Daviedz/ESP-Audio-Player/README.md

# ESP Audio Player

A retro, Winamp-inspired MP3 / FLAC / WAV player and internet radio built on the **Freenove FNK0104B** (ESP32-S3, 2.8" touch display), with a 3D-printable rugged "steel" enclosure.

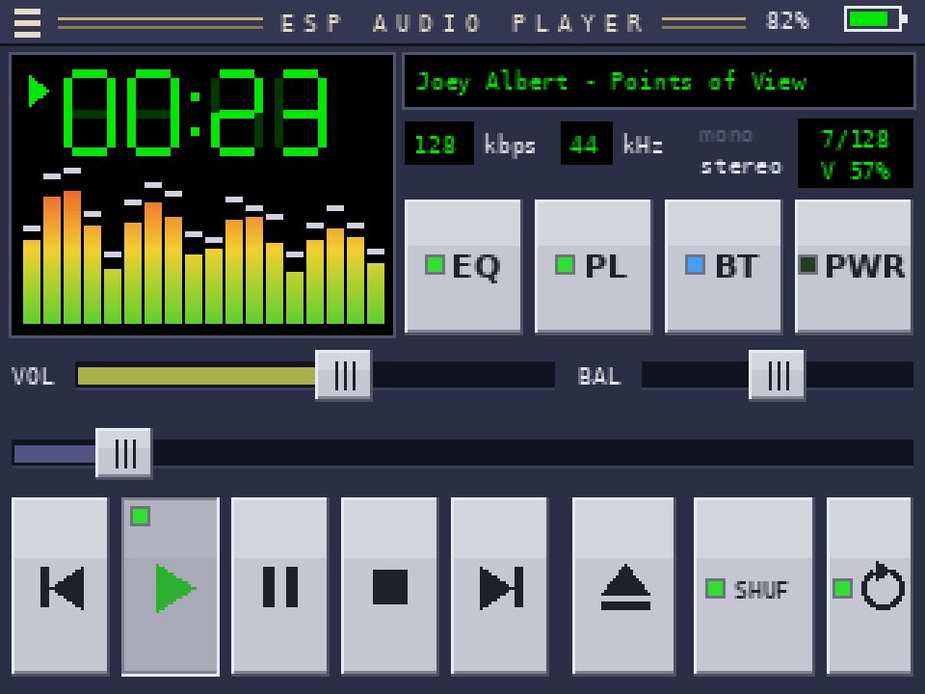
[picture p1: docs/images/retroplay_ui_preview.png]
Main screen


## Features
- RetroPlay-style touch UI: 7-segment time display, spectrum analyzer, scrolling title, silver buttons with indicator lights
- Plays MP3 / FLAC / WAV from microSD (folders, playlists, sort, shuffle, repeat all / one)
- Internet radio over Wi-Fi
- Equalizer with presets, volume + balance, 30-step smooth volume curve
- Remembers settings and the last song + position after power-off
- Battery indicator, low-battery shutdown, power off / wake with a button
- External buttons: POWER, VOL+, VOL-
- Optional Bluetooth transmitter output (Speaker / BT / Both)
- Animated boot screen

| Boot animation | Other screens |
|---|---|
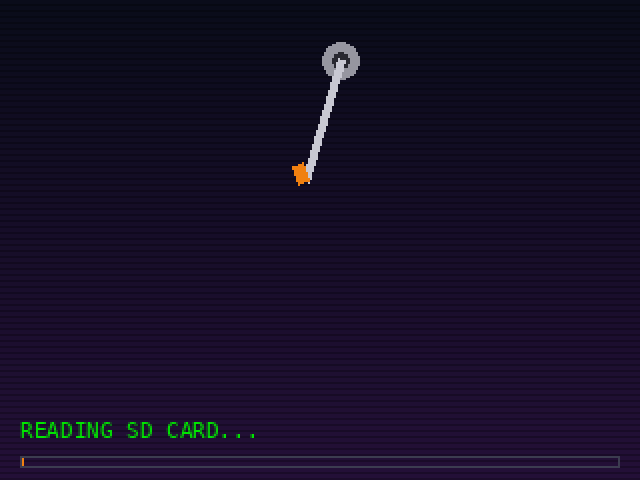
[picture p2: docs/images/boot_animation_preview.gif]
Boot
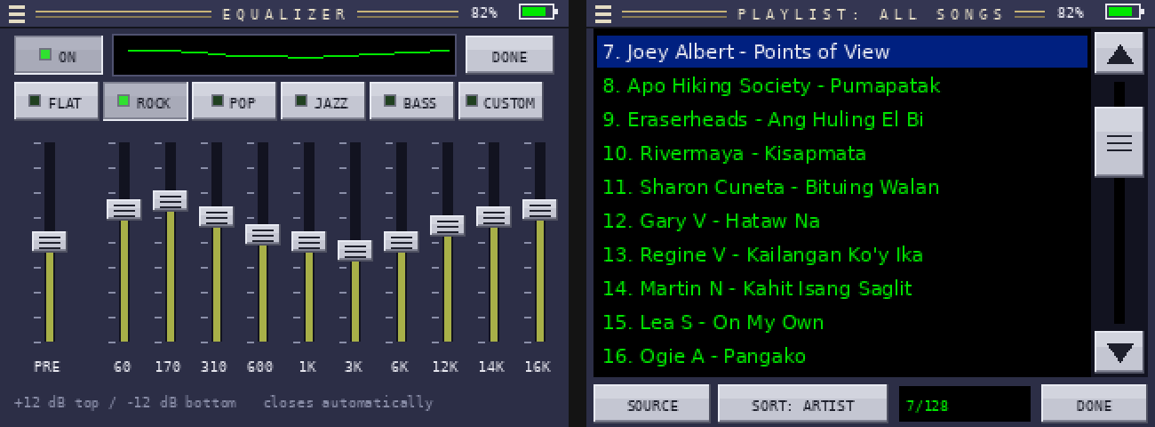
[picture p3: docs/images/retroplay_screens_preview.png]
Screens
|  |  |

## Hardware
| Part | Notes |
|---|---|
| Freenove FNK0104B (ESP32-S3R8, 16 MB flash, 2.8" ILI9341 + FT6336 touch) | ES8311 codec + SC8002B amp on board |
| 2 x 40 mm speaker (SQ-157E, 4 ohm) | mono output |
| 3.7 V 2000 mAh LiPo | |
| 3 x push buttons | POWER = IO21, VOL- = IO2, VOL+ = IO14 (other side to GND) |
| Panel-mount USB-C and microSD extension cables | |
| Optional Bluetooth transmitter (e.g. KCX_BT_EMITTER) | power switched by IO3, audio from ES8311 OUTP |

## Build the firmware
1. Arduino IDE with **esp32 by Espressif** board package (3.x).
2. Libraries: **ESP32-audioI2S** (schreibfaul1), **arduino-audio-driver** (pschatzmann), **LovyanGFX**.
3. Tools settings: Board **ESP32S3 Dev Module**, PSRAM **OPI PSRAM**, Flash **16MB**, Partition **Huge APP (3MB No OTA)**.
4. Open `firmware/WinampPlayer/WinampPlayer.ino` and upload.

### USB drive mode (add songs without removing the SD card)
Tools settings for this feature: **USB Mode = USB-OTG (TinyUSB)** and **USB CDC On Boot = Disabled** (with CDC on boot the drive cannot start).
On the player open **PWR > USB DRIVE**: it reboots, the SD card shows up as a drive on the PC (use the board's native USB-C port), copy your songs, **eject the drive on the PC**, then touch **EXIT** (or hold BOOT). The player reboots and rescans the card.
Notes: with these settings the board shows no USB serial port in normal mode, so to upload new firmware hold **BOOT** while plugging in the USB cable. With the default USB Mode the USB DRIVE button just shows a message. If drive mode ever stops unexpectedly the next boot shows the last step and reset code on screen.

Options are at the top of the sketch (`AUTOPLAY_ON_BOOT`, `LCD_ROTATION`, `VOL_MAX_DB`, button pins, Bluetooth pins, `BOOT_ANIM`).

## SD card
- Copy music in any folders (MP3 / FLAC / WAV).
- Playlists: `/playlists/*.m3u` (created from the player too).
- Wi-Fi for radio: create `/wifi.txt` with one `NAME,PASSWORD` per line. Keep this file off GitHub.
- Live radio shows the local time (HH:MM, fetched over NTP) instead of a timer. Set your time zone with `TZ_DEFAULT` in the sketch or a one-line `/timezone.txt` (POSIX TZ string, e.g. `CET-1CEST,M3.5.0,M10.5.0/3`). Default is UTC+8. Shows `--:--` until the time is synced.
- Radio stations: `/radio.txt`, one station per line:
  ```
  # Name, stream URL
  Radio 1, http://136.243.44.41:8010/stream
  My Station, http://example.com:8000/stream
  ```
  Up to 60 stations. If the file is missing the player creates a sample one on the first boot.

## Enclosure
OpenSCAD source and print-ready STLs in [`enclosure/`](enclosure/) — all parts print **without supports** (Bambu Lab P1S, PLA / PETG settings in the spreadsheet). Colourways: orange/white, black/orange, purple/orange.

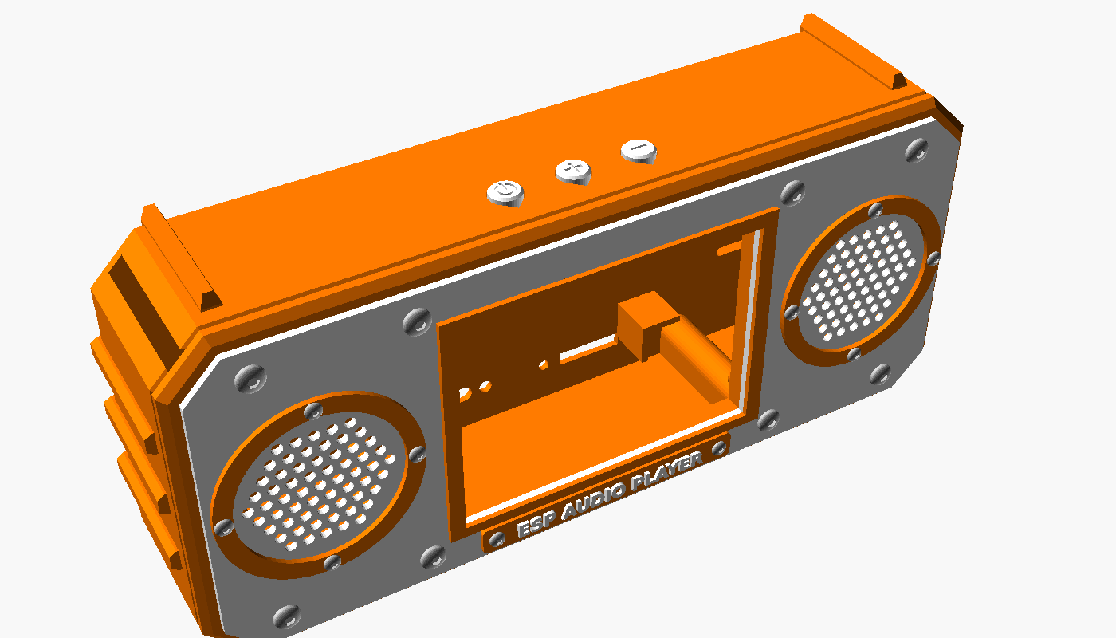
[picture p4: enclosure/images/front_3q.png]
Enclosure


**Print-ready for the Bambu Lab P1S (PLA):** sliced `.gcode.3mf` files in [`enclosure/print_P1S/`](enclosure/print_P1S/) - copy to the SD card and print. See [PRINT_GUIDE.md](enclosure/print_P1S/PRINT_GUIDE.md).

## License
MIT — see [LICENSE](LICENSE).
