Daviedz/ESP-Audio-Player/enclosure/images/back_3q.png

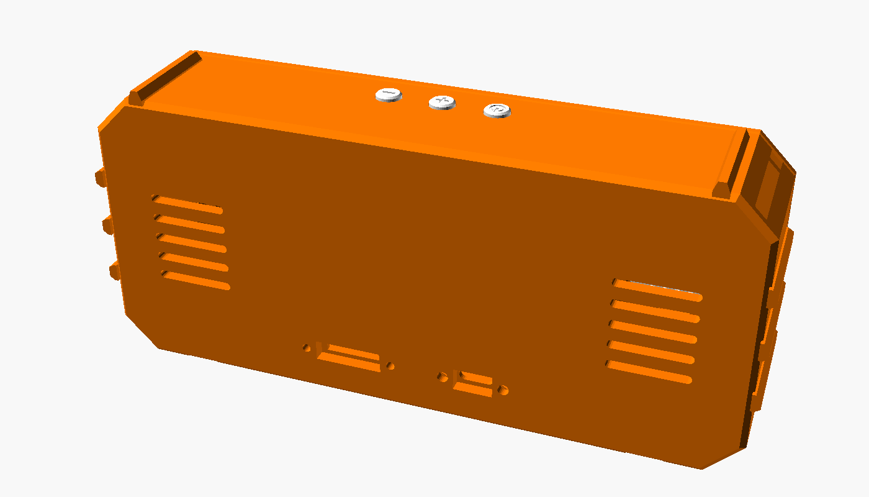
enclosure/images/back_3q.png
