Daviedz/ESP-Audio-Player/enclosure/images/cw_black_orange_3q.png

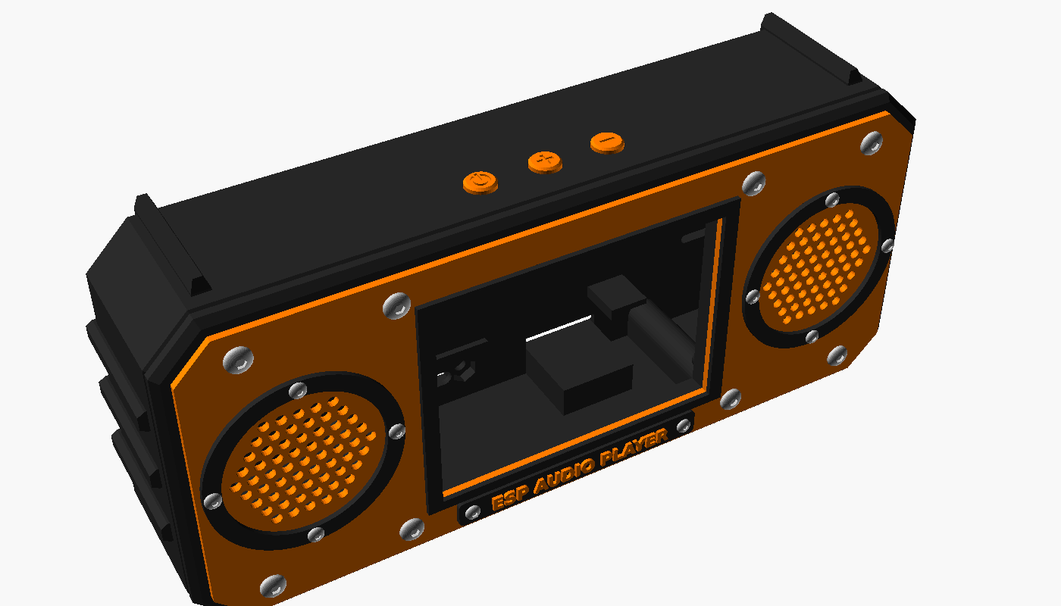
enclosure/images/cw_black_orange_3q.png
