Daviedz/ESP-Audio-Player/enclosure/images/cw_purple_orange_3q.png

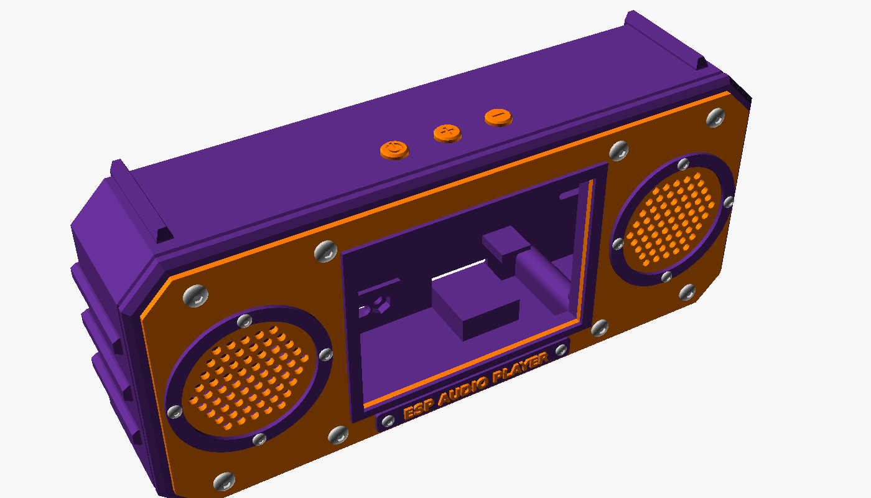
enclosure/images/cw_purple_orange_3q.png
