Daviedz/ESP-Audio-Player/enclosure/images/front_flat.png

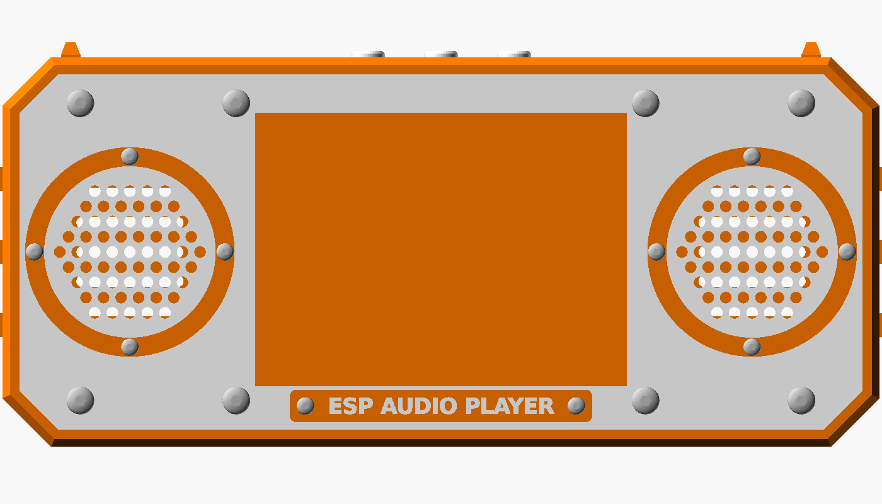
enclosure/images/front_flat.png
