Daviedz/ESP-Audio-Player/enclosure/images/ports_inside.png

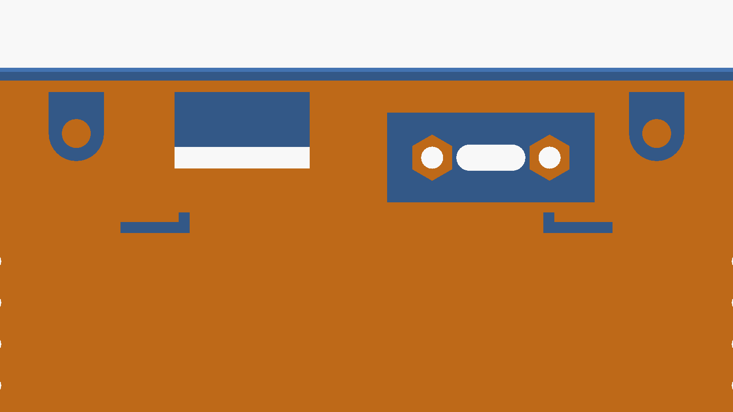
enclosure/images/ports_inside.png
