Daviedz/ESP-Audio-Player/enclosure/images/speaker_mount.png

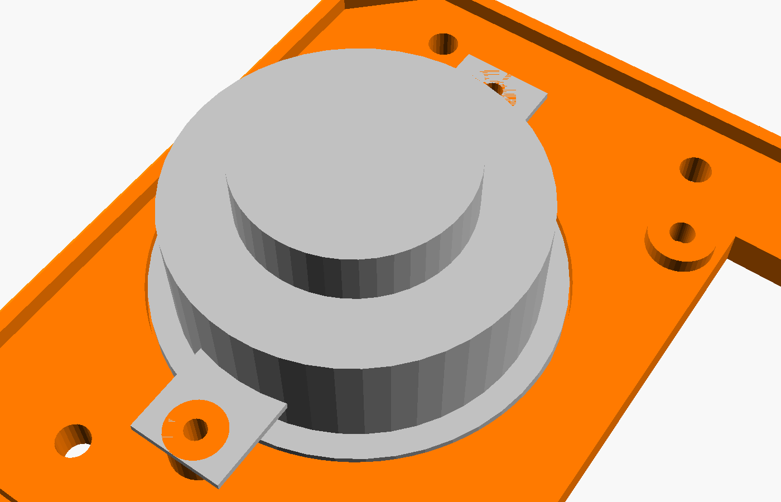
enclosure/images/speaker_mount.png
