Daviedz/ESP-Audio-Player/enclosure/P1S_PLA_PETG_print_settings.xlsx

Sheet: Filament Profiles
Bambu Lab P1S - filament profiles
Printer: Bambu Lab P1S, 0.4 mm nozzle, PLA vs PETG
Setting | PLA | PETG | Notes
Filament preset | Bambu PLA Basic (or any PLA) | Bambu PETG Basic (or any PETG) | Start from the Bambu Studio generic preset for the P1S, 0.4 mm nozzle
Nozzle temperature (C) | 220 | 255 | PLA 215-225, PETG 250-260. First layer same or +5 C
Bed temperature (C) | 55 | 70 | Textured PEI. Smooth PEI: PLA 45-55, PETG 70-75 with glue stick
Build plate | Textured PEI (or Cool Plate) | Textured PEI. Smooth PEI only with glue stick | PETG bonds too hard to bare smooth PEI - use glue stick as a release layer
Part cooling fan (%) | 100 | 30-50 (min 20 / max 50) | Less fan = better layer bonding on PETG
Aux fan (%) | 100 | 30-50 | Keep low for PETG to reduce warping
Chamber / door | Door OPEN or top lid off | Door CLOSED, lid on | PLA softens above ~45 C inside the chamber and can clog (heat creep)
Max volumetric speed (mm3/s) | 18 | 10 | Use 14 for PLA if you want quieter, cleaner walls
Retraction length (mm) | 0.8 | 0.8 | PETG: also enable wipe, keep z-hop 0.4 mm
Outer wall speed (mm/s) | 120 | 80 | Visible orange / white faces - slower looks better
Inner wall speed (mm/s) | 200 | 150
Infill speed (mm/s) | 250 | 150
Bridge speed (mm/s) | 40 | 35 | Used for the port-recess bridges in the shell
Seam position | Back / Aligned | Back / Aligned | Keeps the seam off the visible front
Drying before print | 55 C, 6-8 h | 65 C, 6-8 h | Dry PETG especially if it strings or hisses
Glass transition / heat resistance | ~55-60 C | ~75-80 C | PETG is the safer choice for the body: LiPo, amp and sunlit use
Strength / feel | Stiff, sharp details, brittle | Tougher, slightly flexible, glossy | PLA gives crisper letters and bolt heads
Recommended use in this project | Front plate, white face plate, orange trim, letters, bolt heads, keys | Shell, key bracket (and front plate if you want a heat-resistant body) | Mixing is fine: PLA for the show face, PETG for the shell
Values are typical starting points for Bambu filaments - check the spool label and tune with a small test print.

Sheet: Process Settings
Process settings (both materials)
Slicer: Bambu Studio
Setting | PLA | PETG | Notes
Layer height (mm) | 0.20 (0.12 for letters, heads, keys) | 0.20 (0.16 for keys) | Process preset: 0.20 mm Standard @BBL X1C/P1S
Line width (mm) | 0.42 | 0.42 | Outer wall 0.42
Wall loops | 4 | 4 | Shell and front plate carry the screws and inserts
Top / bottom shell layers | 5 / 4 | 5 / 4 | Overlay, trim: 100% solid (thin parts)
Infill density | 15-20 % | 20-25 % | Gyroid for both
Infill pattern | Gyroid | Gyroid
Support | OFF | OFF | Model is designed support-free
Brim | None (Outer brim 3 mm for the shell if corners lift) | Outer brim 3 mm on shell and front plate | Brim helps PETG on textured PEI edges
Elephant foot compensation (mm) | 0.1 | 0.1 | Matters for the front plate / shell bed edge
Ironing | OFF | OFF
Arc fitting | ON | ON
Z hop (mm) | 0.4 | 0.4 | Avoid drag marks on the front face
Slow down for overhang | ON | ON | Bridges in shell: flow ratio 0.95
Detect thin walls | ON | ON | Letter strokes are ~0.7 mm
Fuzzy skin / adaptive layers | OFF | OFF

Sheet: Per-Part Settings
Per-part settings
All parts print without supports
STL | Part | Colour | Qty | Orientation | Material | Layer (mm) | Walls / infill | Support | Notes
steel_front.stl | Front plate | Orange | 1 | Front face DOWN (as exported) | PLA or PETG | 0.20 | 4 walls, 20 % | None | Needs M3 holes + heat-set insert clean. Large flat part: PETG add brim
steel_overlay.stl | White face plate (1.6 mm) | White | 1 | Flat on bed (face down) | PLA | 0.20 | 100 % solid (thin) | None | Glue to the front plate; perforations print upright
steel_trim.stl | Bezel, speaker rings, nameplate base (1.2 mm) | Orange | 1 | Flat on bed | PLA | 0.12-0.20 | 100 % solid | None | Glue on top of the white plate
steel_letters.stl | Letters ESP AUDIO PLAYER (0.8 mm) | White | 1 | Flat on bed | PLA | 0.12 | 100 % solid | None | Thin strokes - use 0.12 mm, slow 40 mm/s first layers
steel_heads_small.stl | Small round bolt heads 3.6 mm (speaker rings + nameplate) | Silver / white | 10 | Dome UP | PLA | 0.12 | 100 % solid | None | Print the 10 together, glue on
steel_heads_big.stl | Big round bolt heads 5.7 mm (front corners, optional vs real screws) | Silver / white | 8 | Dome UP | PLA | 0.12 | 100 % solid | None | Print the 10 together, glue on
steel_shell.stl | Rear shell | Orange | 1 | Back face DOWN, open side up (as exported) | PETG (preferred) or PLA | 0.20 | 4 walls, 20-25 % | None | Bridges <= 6.4 mm at port recesses and switch pockets are fine; brim 3 mm
steel_bracket.stl | Key switch bracket | Any | 1 | As exported | PETG or PLA | 0.16 | 100 % | None | Switch pockets bridge ~6 mm
steel_keys.stl | 3 key caps | White | 3 | Flange DOWN | PLA | 0.12-0.16 | 100 % | None | Check 7.0 mm cap moves freely in 7.4 mm hole

Sheet: Notes
Notes
- Print order: shell first (longest print, also checks the ports), then front plate, then the thin parts.
- Test fit: print the front plate or a small port test before the full set.
- Two-colour nameplate: letters can be glued on, or print trim + letters together and add a colour change at 1.2 mm.
- Hardware: 8 x M3x12 ISO 7380 button-head screws, 8 x M3 heat-set inserts, 2 x M3x6 + 2 x M3 nuts (USB-C), 2 x M2x8 bracket screws, 3 tact switches 6x6x5.
- PETG note: do not print PETG directly on smooth PEI without glue stick - it can tear the plate coating.
- PLA note: keep the P1S door open / lid off for long prints to avoid heat creep.
- Source: typical Bambu Lab PLA Basic / PETG Basic profiles and common P1S practice; values are starting points, not guarantees.
