Daviedz/ESP-Audio-Player/enclosure/print_P1S/1_shell_PLA_orange.gcode.3mf

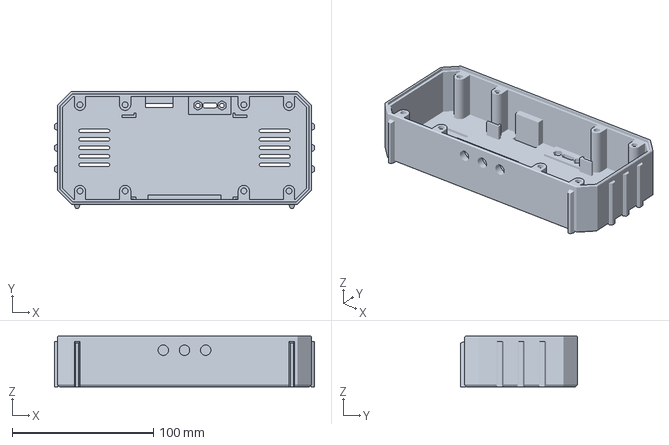
[picture p11: CAD file, 2026-11-07]
enclosure/print_P1S/1_shell_PLA_orange.gcode.3mf
184.0 x 83.0 x 36.0 mm
