Daviedz/ESP-Audio-Player/enclosure/print_P1S/6_small_parts_PLA_white.gcode.3mf

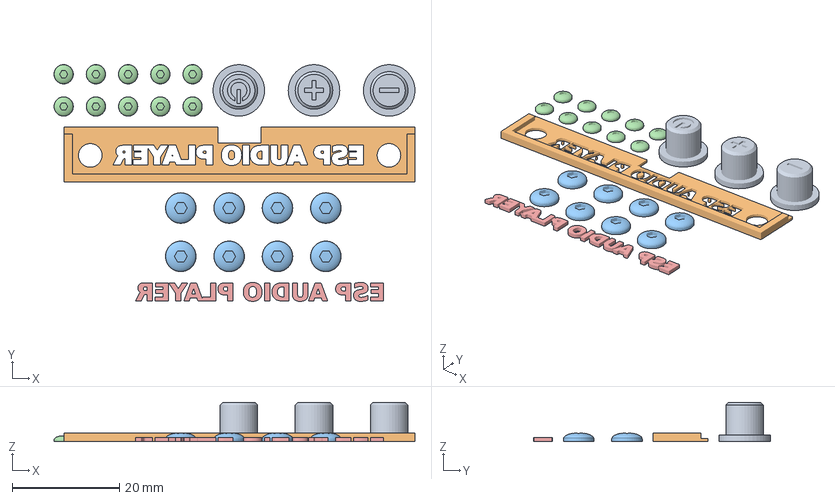
[picture p12: CAD file, 2026-11-07]
enclosure/print_P1S/6_small_parts_PLA_white.gcode.3mf
67.2 x 44.1 x 7.30 mm
D:/Claude Project/ESP-Audio-Player-main/enclosure/stl/steel_keys.stl
D:/Claude Project/ESP-Audio-Player-main/enclosure/stl/steel_letter_jig.stl
D:/Claude Project/ESP-Audio-Player-main/enclosure/stl/steel_heads_big.stl
D:/Claude Project/ESP-Audio-Player-main/enclosure/stl/steel_heads_small.stl
D:/Claude Project/ESP-Audio-Player-main/enclosure/stl/steel_letters.stl
