Daviedz/ESP-Audio-Player/enclosure/stl/steel_bracket.stl

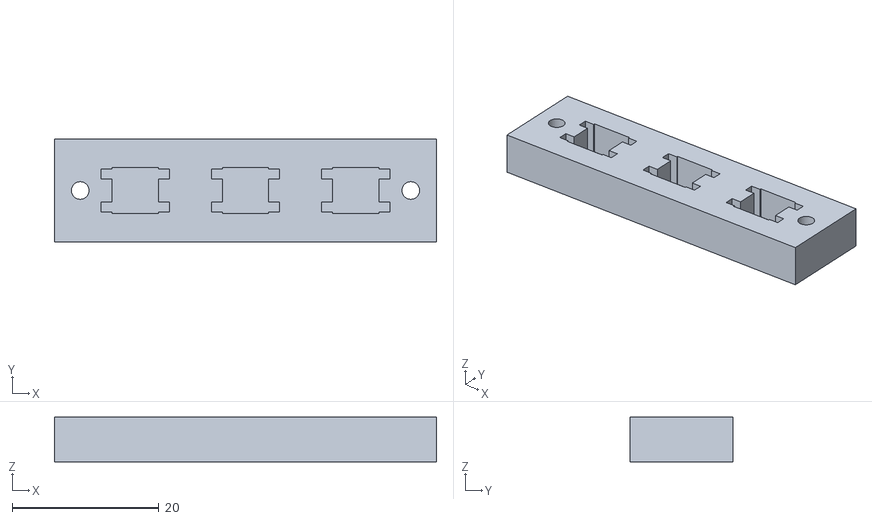
[picture p13: CAD file, 2026-11-05]
enclosure/stl/steel_bracket.stl
52.0 x 14.0 x 6.10
