Daviedz/ESP-Audio-Player/enclosure/print_P1S/4_white_face_plate_PLA_white.gcode.3mf

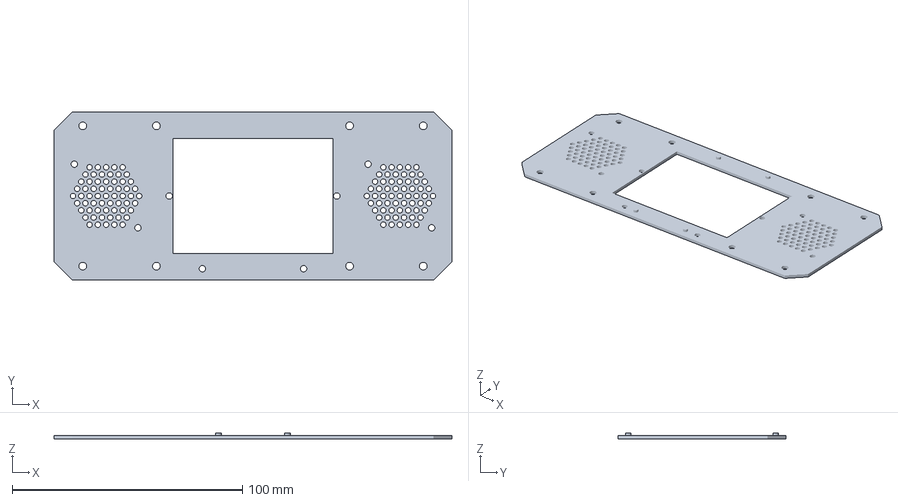
[picture p14: CAD file, 2026-11-07]
enclosure/print_P1S/4_white_face_plate_PLA_white.gcode.3mf
173.0 x 73.0 x 2.80 mm
