Daviedz/ESP-Audio-Player/enclosure/stl/steel_keys.stl

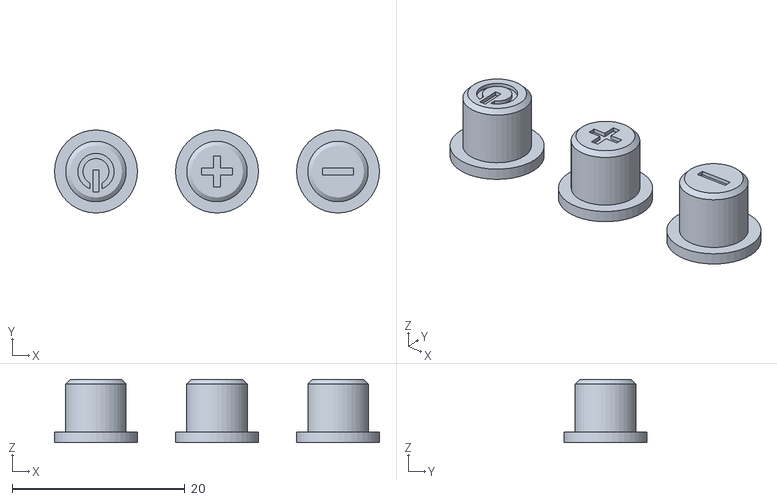
[picture p15: CAD file, 2026-11-05]
enclosure/stl/steel_keys.stl
37.6 x 9.60 x 7.30
