Daviedz/ESP-Audio-Player/enclosure/print_P1S/3_front_plate_PLA_orange.gcode.3mf

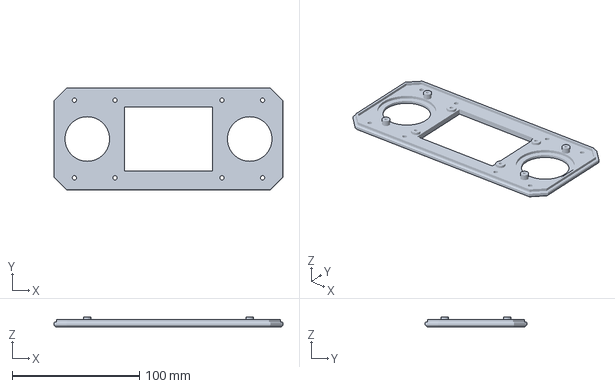
[picture p16: CAD file, 2026-11-07]
enclosure/print_P1S/3_front_plate_PLA_orange.gcode.3mf
180.0 x 80.0 x 8.00 mm
