Daviedz/ESP-Audio-Player/enclosure/stl/steel_letters.stl

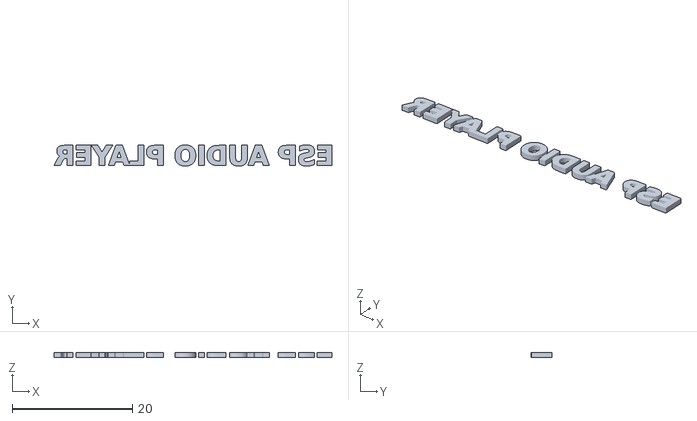
[picture p17: CAD file, 2026-11-05]
enclosure/stl/steel_letters.stl
46.2 x 3.53 x 0.81
