Daviedz/ESP-Audio-Player/enclosure/print_P1S/5_trim_PLA_orange.gcode.3mf

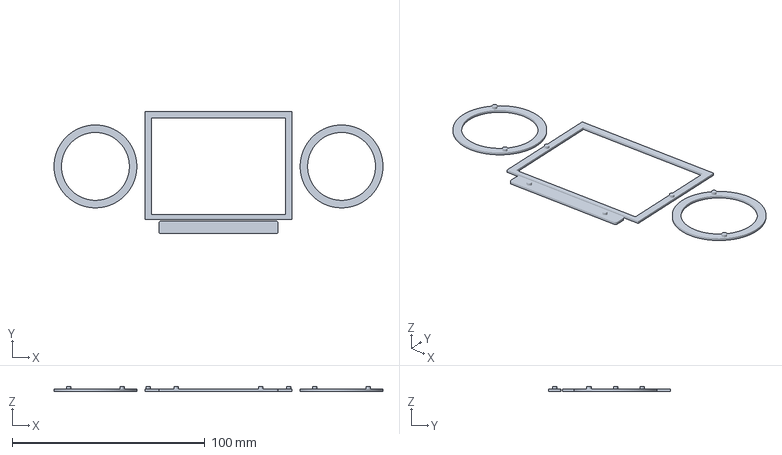
[picture p18: CAD file, 2026-11-07]
enclosure/print_P1S/5_trim_PLA_orange.gcode.3mf
170.7 x 63.5 x 2.40 mm
