Daviedz/ESP-Audio-Player/enclosure/stl/steel_letter_jig.stl

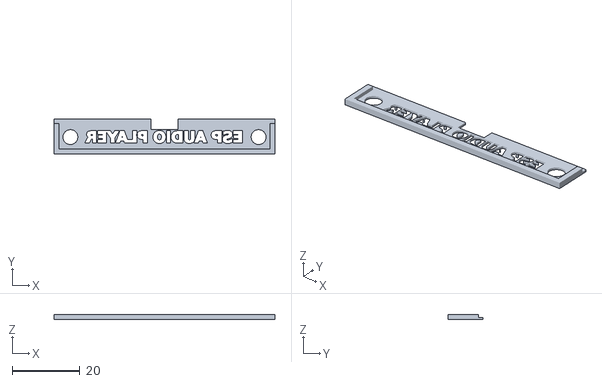
[picture p19: CAD file, 2026-11-05]
enclosure/stl/steel_letter_jig.stl
65.3 x 10.2 x 1.59
