Daviedz/ESP-Audio-Player/enclosure/stl/steel_heads_big.stl

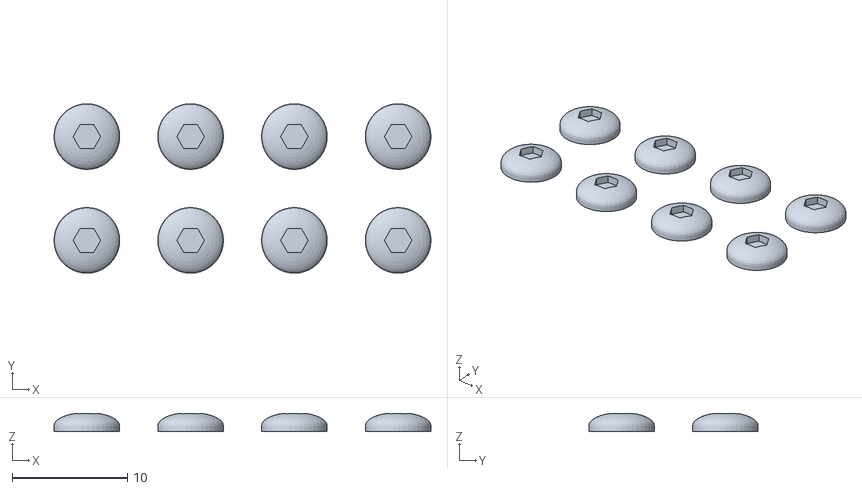
[picture p20: CAD file, 2026-11-05]
enclosure/stl/steel_heads_big.stl
32.7 x 14.7 x 1.57
