Daviedz/ESP-Audio-Player/enclosure/stl/steel_heads_small.stl

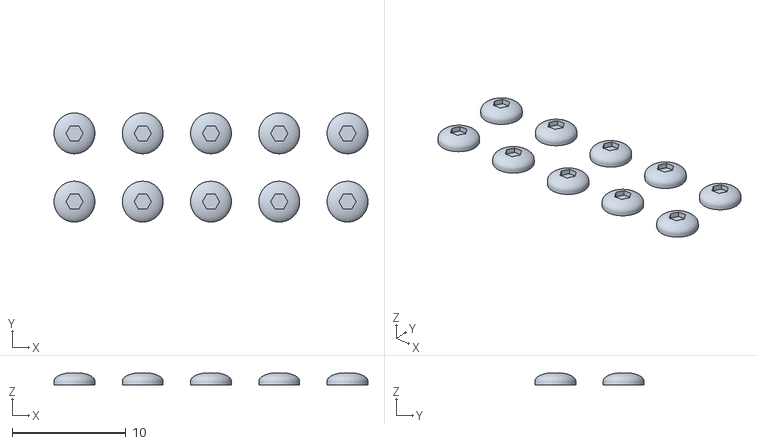
[picture p21: CAD file, 2026-11-05]
enclosure/stl/steel_heads_small.stl
27.6 x 9.60 x 1.05
