Daviedz/ESP-Audio-Player/(list of files, cad)

Other CAD files:
enclosure/stl/steel_shell.stl
enclosure/stl/steel_overlay.stl
enclosure/print_P1S/2_bracket_PLA.gcode.3mf
enclosure/stl/steel_trim.stl
enclosure/stl/steel_front.stl
