Daviedz/ESP-Audio-Player/enclosure/images/letters_step3.png

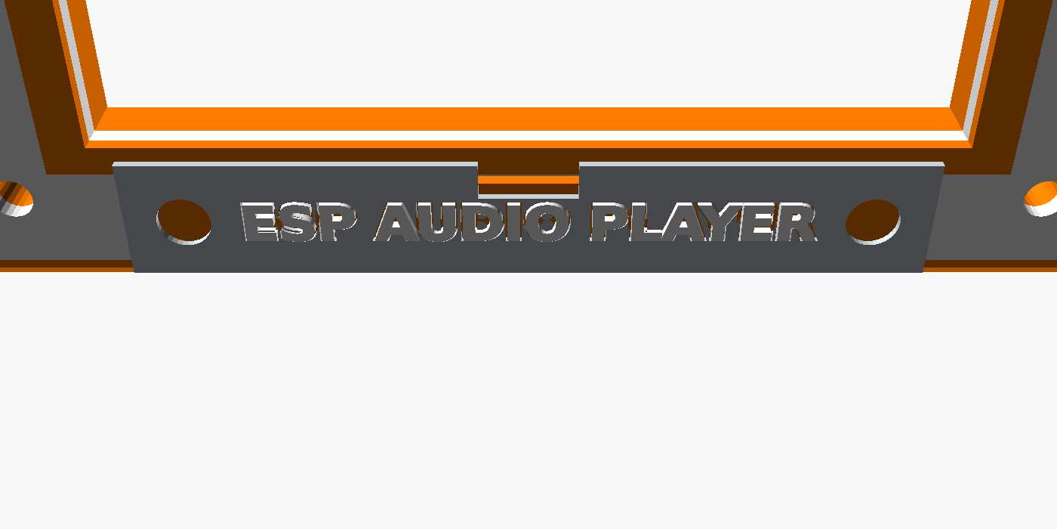
enclosure/images/letters_step3.png
