Daviedz/ESP-Audio-Player/(commit log)

2026-11-05 Initial commit: ESP Audio Player firmware and enclosure
    - Winamp-inspired RetroPlay touch UI for the Freenove FNK0104B (ESP32-S3)
    - SD music player, internet radio, EQ, playlists, BT transmitter output
    - Support-free 3D-printable steel-style enclosure (OpenSCAD + STLs)
    - Bambu Lab P1S PLA/PETG print settings
    Claude-Session: https://claude.ai/code/session_0191h23bQwpSqWFwxE8SvSCL
    [P1S_PLA_PETG_print_settings.xlsx, audioplayer_steel.scad, steel_bracket.stl, steel_front.stl, steel_heads_big.stl, steel_heads_small.stl, steel_keys.stl, steel_letter_jig.stl]
2026-11-05 Load radio stations from /radio.txt on the SD card
    Stations are no longer hard-coded: one "Name, URL" per line in /radio.txt
    (up to 60). A sample file is created on first boot when it is missing.
    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
    [WinampPlayer.ino]
2026-11-06 Add P1S print-ready PLA plates and print guide
    [1_shell_PLA_orange.gcode.3mf, 2_bracket_PLA.gcode.3mf, 3_front_plate_PLA_orange.gcode.3mf, 4_white_face_plate_PLA_white.gcode.3mf, 5_trim_PLA_orange.gcode.3mf, 6_small_parts_PLA_white.gcode.3mf]
2026-11-06 Larger battery bay (55.05 x 67.38 x 9.19 incl. wire), ports moved down 3 mm, re-sliced shell
    [1_shell_PLA_orange.gcode.3mf, audioplayer_steel.scad, steel_shell.stl]
2026-11-07 Print plates: carry filament colour for AMS matching, add AMS section to print guide
    [1_shell_PLA_orange.gcode.3mf, 2_bracket_PLA.gcode.3mf, 3_front_plate_PLA_orange.gcode.3mf, 4_white_face_plate_PLA_white.gcode.3mf, 5_trim_PLA_orange.gcode.3mf, 6_small_parts_PLA_white.gcode.3mf]
2026-11-07 Add USB drive mode: SD card appears as a drive on the PC (PWR > USB DRIVE)
    Multi-sector transfers, one-shot boot flag, crash diagnostics on next boot.
    Requires USB Mode = USB-OTG (TinyUSB) and USB CDC On Boot = Disabled.
    [WinampPlayer.ino]
2026-11-09 Live radio: show local time (NTP, UTC+8, 12 h) with AM/PM indicator instead of a timer
